attilabody/espdimmer/case/ESPDimmer.FCStd

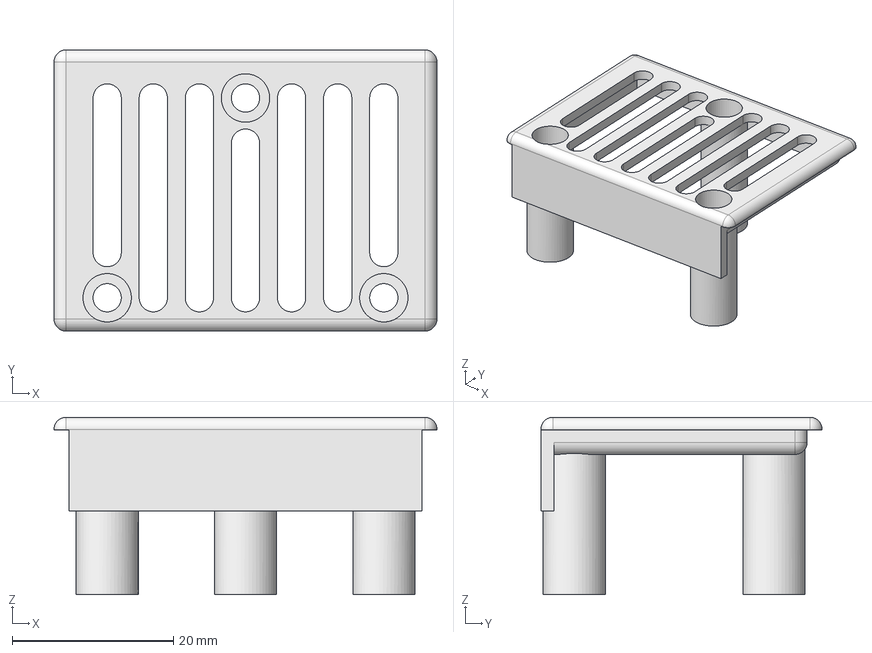
[picture p1: CAD file, 2021-06-22]
case/ESPDimmer.FCStd
47.5 x 34.9 x 22.0 mm
