attilabody/espdimmer/electronics/espdimmer.kicad_pcb

## KiCad design electronics/espdimmer.kicad_pcb (2021-06-22)

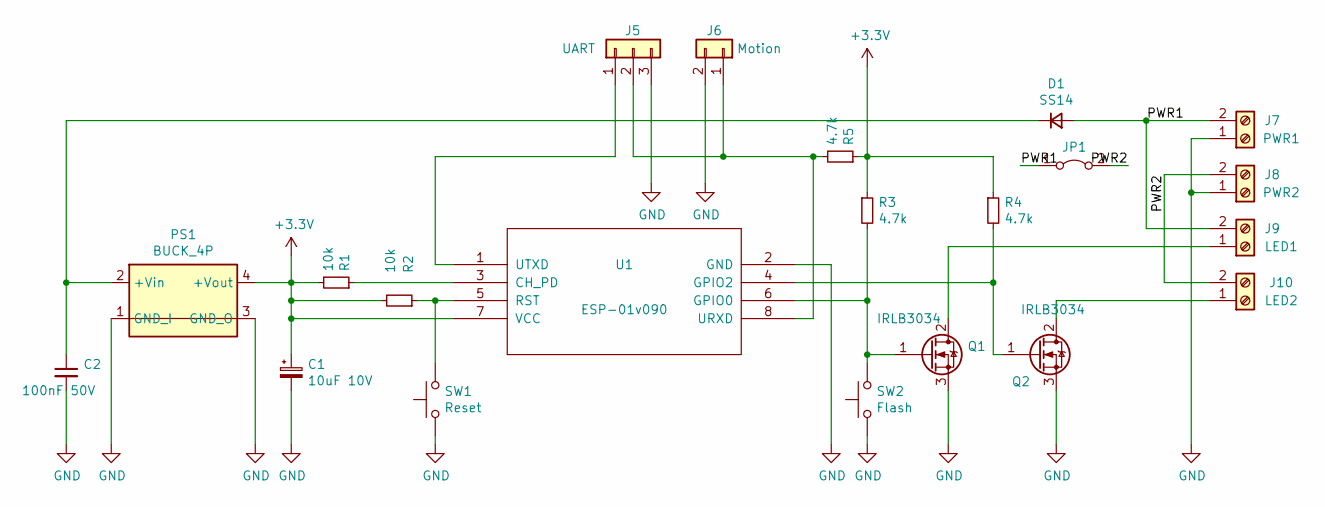
[picture p2: schematic espdimmer.sch]

Parts:
C1: 10uF 10V; CP_EIA-3216-10_Kemet-I_Pad1.58x1.35mm_HandSolder
C2: 100nF 50V; C_0805_2012Metric_Pad1.15x1.40mm_HandSolder
D1: SS14; D_SMA_Handsoldering
J5: UART; PinHeader_1x03_P2.54mm_Vertical
J6: Motion; PinHeader_1x02_P2.54mm_Vertical
J7: PWR1; TerminalBlock_bornier-2_P5.08mm
J8: PWR2; TerminalBlock_bornier-2_P5.08mm
J9: LED1; TerminalBlock_bornier-2_P5.08mm
J10: LED2; TerminalBlock_bornier-2_P5.08mm
JP1: Jumper_2_Bridged; SolderJumper-2_P1.3mm_Open_TrianglePad1.0x1.5mm
PS1: BUCK_4P; XM1584_buck_mod_4p
Q1, Q2: IRLB3034; TO-220-3_Vertical
R1, R2: 10k; R_0805_2012Metric_Pad1.15x1.40mm_HandSolder
R3, R4, R5: 4.7k; R_0805_2012Metric_Pad1.15x1.40mm_HandSolder
SW1: Reset; SW_PUSH_6mm
SW2: Flash; SW_PUSH_6mm
U1: ESP-01v090; ESP-01

Connections:
+3V3: C1.1, PS1.4 (+Vout), R1.2, R2.2, R3.1, R4.1, R5.1, U1.7 (VCC)
/PWR1: D1.2 (A), J7.2, J9.2, JP1.1 (A)
/PWR2: J8.2, J10.2, JP1.2 (B)
GND: C1.2, C2.2, J5.3, J6.2, J7.1, J8.1, PS1.1 (GND_I), PS1.3 (GND_O), Q1.3 (S), Q2.3 (S), SW1.2, SW2.2, U1.2 (GND)
unnamed: C2.1, D1.1 (K), PS1.2 (+Vin)
unnamed: J5.1, U1.1 (UTXD)
unnamed: J5.2, J6.1, R5.2, U1.8 (URXD)
unnamed: J9.1, Q1.2 (D)
unnamed: J10.1, Q2.2 (D)
unnamed: Q1.1 (G), R3.2, SW2.1, U1.6 (GPIO0)
unnamed: Q2.1 (G), R4.2, U1.4 (GPIO2)
unnamed: R1.1, U1.3 (CH_PD)
unnamed: R2.1, SW1.1, U1.5 (RST)

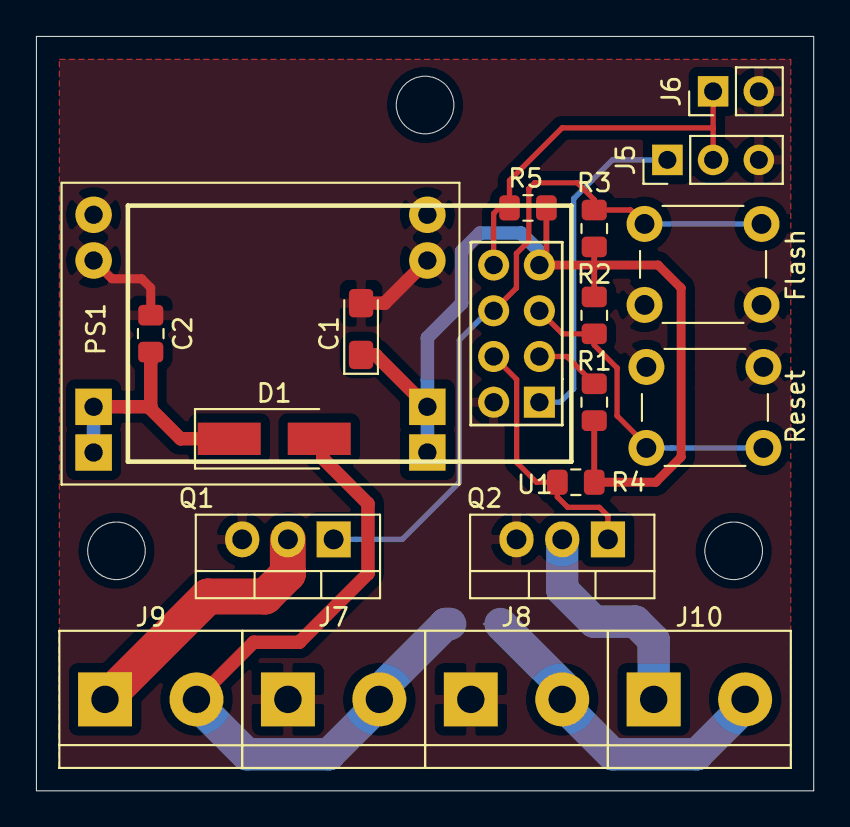
[picture p3: board espdimmer.kicad_pcb from above]

Board: 2 copper layers, 43.2 x 41.9 mm, 21 parts (1 on the bottom side), 13 nets.
