attilabody/espdimmer/(commit log)

2021-01-10 PCB V1 (narrow)
    [espdimmer.kicad_pcb, espdimmer.sch]
2021-01-19 Schematics and PCB design updated
    [espdimmer.kicad_pcb, espdimmer.sch]
2021-01-22 Schematics/PCB updated
    [espdimmer.kicad_pcb, espdimmer.sch]
2021-05-13 esphome config added
    [espdimmer.kicad_pcb, espdimmer.sch]
2021-05-13 git subrepo clone (merge) https://github.com/jdunmire/kicad-ESP8266.git electronics/esp8266
    subrepo:
    subdir: "electronics/esp8266"
    merged: "1f3d2c6"
    upstream:
    origin: "https://github.com/jdunmire/kicad-ESP8266.git"
    branch: "master"
    commit: "1f3d2c6"
    git-subrepo:
    version: "0.4.3"
    origin: "https://github.com/ingydotnet/git-subrepo"
    commit: "87ee373"
2021-05-13 switched to internal esp8266 libs
    [espdimmer.kicad_pcb, espdimmer.sch]
2021-06-22 Housing added
    [ESPDimmer.FCStd, espdimmer.kicad_pcb, espdimmer.sch]
